Infern0451/t7bridge/enclosure/README.md

# T7 Bridge enclosure (3D printed)

Sealed two-part case for an ESP32-S3 DevKitC-style board **without pin
headers** (measured board: 57 × 28.1 mm plus a 6 × 18 mm antenna tab, 4.8 mm
tall). Outside size: **97.2 × 36.3 × 14.0 mm**, all outside edges rounded
(1.5 mm fillet).

## Pick your version

The cable goes into the board's **USB** port. On many of these boards only the
USB port has the resistors that make USB-C chargers, power banks, laptops and
the bike's own USB-C port switch their 5 V on; the COM port only powers up from
USB-A cables and "dumb" 12 V converters. Pick the version by your cable's
thickness, not counting the strain relief:

| Version | Cable hole | For cables |
|---|---|---|
| `type1` | 5.0 mm | up to ~4.6 mm (most Anker, Belkin, Amazon Basics braided) |
| `type2` | 6.5 mm | up to ~6 mm (heavy braided) |

Each version is one **3MF** file (`print/t7bridge_case_type1.3mf` or
`..._type2.3mf`) with the base, lid and gasket laid out on one plate, already
in print orientation: open it in Orca / Bambu Studio / PrusaSlicer. The parts
are separate objects, so you can give the gasket TPU or delete it if you use
RTV instead.

The board goes in **components up** (silver metal shield and buttons visible,
pin labels facing the floor). Its edges rest on the floor ribs, a stop at the
port end keeps it from sliding, and two pads under the lid (over the metal
shield and over the USB-C sockets) stop it lifting over that stop. The pads
clear the board by 0.5 mm, so nothing is pressed on.

On the project's N16R8 board the two USB-C ports are 11.8 mm apart and
symmetric about the centreline; components up, USB is on the left. For a
different board edit `PORT_OFFSETS`; for a COM-port case run
`python3 make_case.py --port com`.

| Part | Print in | Orientation (as exported) |
|---|---|---|
| base | PETG | open side up |
| lid | PETG | top face on the bed, lip up |
| gasket | TPU 95A (optional) | flat |

**Print settings (PETG):** 0.2 mm layers, **4 perimeters** (helps keep water
out), 3 top/bottom layers or more, 25-40 % infill, no supports. The zip-tie
channels on the bottom faces are short bridges that print fine.

## What you need

- A **short USB-C cable with a straight plug** on the board end. The case
  holds the plug inside: up to about 27 mm from the metal tip to the end of
  the strain relief, 13 mm wide and 7.5 mm thick. The bike end can be
  right-angled.
- Either the printed TPU gasket or a tube of **neutral-cure RTV silicone**.
- **Two zip ties** up to 5 mm wide.
- Optional: a small piece of foam tape on top of the board to stop rattles.
- **3M VHB** tape for mounting.

## Assembly

1. **Dry-fit first.** Put the board in (components up, antenna end against
   the far wall, USB end towards the notch), close the lid, check it seats.
2. Plug the cable into the board's **USB** port and lay the cable in the notch.
3. Fit the gasket in the groove, **or** run a thin bead of RTV in the groove.
   Add a dab of RTV around the cable where it passes through the notch.
4. Press the lid on and fit two zip ties in the channels, snug, not crushing.
5. Mount with VHB on the flat bottom between the channels.

Keep metal (brackets, foil tape) away from the antenna end, opposite the USB
plug.

## Changing the size

All dimensions are at the top of `make_case.py`. Edit them and run:

```sh
python3 make_case.py                      # type1 and type2 (USB port)
python3 make_case.py --port com --cable 1 # a COM-port version
```

(Needs Python 3 and numpy.) It regenerates the 3MF files and checks every
part is watertight. Add `--stl` for separate STL files too (about 20 MB
each, too big for GitHub's web upload, so they aren't in the repo).

## License

CC BY-SA 4.0 (see `LICENSE` in this folder). Share and remix freely, with credit, under the same license.
