Infern0451/t7bridge/enclosure/print/t7bridge_case_type1.3mf

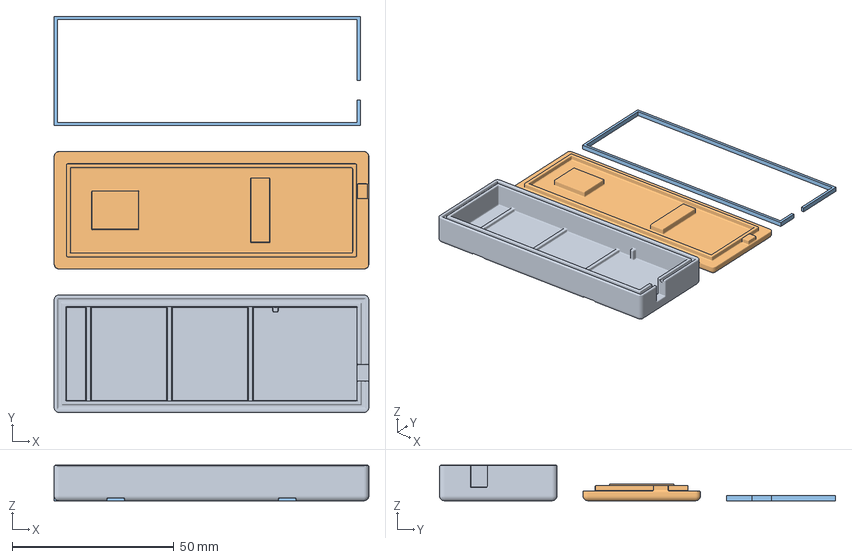
[picture p1: CAD file, 2026-11-12]
enclosure/print/t7bridge_case_type1.3mf
97.2 x 122.3 x 11.0 mm
base
lid
gasket (TPU, optional)
