Infern0451/t7bridge/(list of files, cad)

Other CAD files:
enclosure/print/t7bridge_case_type2.3mf
