Infern0451/t7bridge/main/learn_mode.c

/*
 * Learn mode. See learn_mode.h.
 */
#include "learn_mode.h"

#include <stdarg.h>
#include <stdio.h>
#include <string.h>

#include "driver/gpio.h"
#include "esp_log.h"
#include "esp_system.h"
#include "freertos/FreeRTOS.h"
#include "freertos/task.h"
#include "host/ble_hs.h"
#include "host/ble_store.h"
#include "nvs.h"
#include "services/gap/ble_svc_gap.h"

#include "creds.h"
#include "iphone_link.h"
#include "ota_update.h"
#include "yamaha_proto.h"

static const char *TAG = "learn";

#define BOOT_GPIO          GPIO_NUM_0
#define RESET_HOLD_MS      5000
#define FINISH_DELAY_MS    8000     /* keep the app link a while after the ACK */

/* Nordic UART Service, same UUIDs as the CCU. */
static const ble_uuid128_t NUS_SVC = BLE_UUID128_INIT(
    0x9E, 0xCA, 0xDC, 0x24, 0x0E, 0xE5, 0xA9, 0xE0, 0x93, 0xF3, 0xA3, 0xB5, 0x01, 0x00, 0x40, 0x6E);
static const ble_uuid128_t NUS_RX = BLE_UUID128_INIT(
    0x9E, 0xCA, 0xDC, 0x24, 0x0E, 0xE5, 0xA9, 0xE0, 0x93, 0xF3, 0xA3, 0xB5, 0x02, 0x00, 0x40, 0x6E);
static const ble_uuid128_t NUS_TX = BLE_UUID128_INIT(
    0x9E, 0xCA, 0xDC, 0x24, 0x0E, 0xE5, 0xA9, 0xE0, 0x93, 0xF3, 0xA3, 0xB5, 0x03, 0x00, 0x40, 0x6E);

static uint16_t s_tx_val;
static volatile bool s_synced;
static volatile bool s_running;
static volatile uint16_t s_conn = BLE_HS_CONN_HANDLE_NONE;
static volatile int64_t s_finish_at;      /* 0 = not finishing */
static uint8_t s_own_addr_type;
static char s_name[32];

static uint8_t s_buf[YAM_LEN_AUTH];
static size_t s_buf_len;
static int s_other_writes;

static int64_t now_ms(void)
{
    return (int64_t)(xTaskGetTickCount() * portTICK_PERIOD_MS);
}

/* Recent learn-mode events, shown on the setup page (no computer needed). */
#define EV_LINES 24
#define EV_LEN   96
static char s_ev[EV_LINES][EV_LEN];
static int s_ev_next, s_ev_count;
static portMUX_TYPE s_ev_mux = portMUX_INITIALIZER_UNLOCKED;

static void ev(const char *fmt, ...)
{
    char line[EV_LEN];
    int64_t t = now_ms();
    int n = snprintf(line, sizeof line, "%3d:%02d  ", (int)(t / 60000), (int)(t / 1000 % 60));
    va_list ap;
    va_start(ap, fmt);
    vsnprintf(line + n, sizeof line - n, fmt, ap);
    va_end(ap);
    ESP_LOGI(TAG, "%s", line + n);
    portENTER_CRITICAL(&s_ev_mux);
    memcpy(s_ev[s_ev_next], line, EV_LEN);
    s_ev_next = (s_ev_next + 1) % EV_LINES;
    if (s_ev_count < EV_LINES) {
        s_ev_count++;
    }
    portEXIT_CRITICAL(&s_ev_mux);
}

size_t learn_mode_events(char *buf, size_t cap)
{
    size_t used = 0;
    buf[0] = 0;
    portENTER_CRITICAL(&s_ev_mux);
    int first = (s_ev_next - s_ev_count + EV_LINES) % EV_LINES;
    for (int i = 0; i < s_ev_count && used + EV_LEN + 2 < cap; i++) {
        used += snprintf(buf + used, cap - used, "%s\n", s_ev[(first + i) % EV_LINES]);
    }
    portEXIT_CRITICAL(&s_ev_mux);
    return used;
}

/* ---------------------------------------------------------------------- */
/* The real CCU's advertising, recorded so learn mode can replay it exactly. */
/* Newer CCUs advertise more than their name (e.g. an Apple notification    */
/* service solicitation), and some Y-Connect versions check for it.         */
/* ---------------------------------------------------------------------- */

#define ADV_MAX 31
static uint8_t s_cap_adv[ADV_MAX], s_cap_rsp[ADV_MAX];
static uint8_t s_cap_adv_len, s_cap_rsp_len;
static bool s_cap_loaded, s_cap_complete, s_cap_dirty;
static int64_t s_cap_adv_at;

static void hex(char *out, size_t cap, const uint8_t *d, size_t n)
{
    size_t o = 0;
    for (size_t i = 0; i < n && o + 3 <= cap; i++) {
        o += snprintf(out + o, cap - o, "%02X", d[i]);
    }
    if (o == 0 && cap > 0) {
        out[0] = 0;
    }
}

static void cap_load(void)
{
    if (s_cap_loaded) {
        return;
    }
    s_cap_loaded = true;
    nvs_handle_t h;
    if (nvs_open("t7creds", NVS_READONLY, &h) != ESP_OK) {
        return;
    }
    size_t a = ADV_MAX, r = ADV_MAX;
    if (nvs_get_blob(h, "ccu_adv", s_cap_adv, &a) == ESP_OK && a > 0) {
        s_cap_adv_len = (uint8_t)a;
        if (nvs_get_blob(h, "ccu_rsp", s_cap_rsp, &r) == ESP_OK) {
            s_cap_rsp_len = (uint8_t)r;
        }
        s_cap_complete = true;
    }
    nvs_close(h);
}

static void cap_save(void)
{
    nvs_handle_t h;
    if (nvs_open("t7creds", NVS_READWRITE, &h) != ESP_OK) {
        return;
    }
    nvs_set_blob(h, "ccu_adv", s_cap_adv, s_cap_adv_len);
    if (s_cap_rsp_len) {
        nvs_set_blob(h, "ccu_rsp", s_cap_rsp, s_cap_rsp_len);
    } else {
        nvs_erase_key(h, "ccu_rsp");
    }
    nvs_commit(h);
    nvs_close(h);
}

static void cap_finish(void)
{
    char hx[2 * ADV_MAX + 1];
    s_cap_complete = true;
    s_cap_dirty = true;
    cap_save();
    hex(hx, sizeof hx, s_cap_adv, s_cap_adv_len);
    ev("recorded the bike's advertising: %s", hx);
    if (s_cap_rsp_len) {
        hex(hx, sizeof hx, s_cap_rsp, s_cap_rsp_len);
        ev("recorded the bike's scan response: %s", hx);
    } else {
        ev("the bike sent no scan response");
    }
}

void learn_mode_capture(const uint8_t *data, uint8_t len, bool scan_rsp)
{
    cap_load();
    if (len > ADV_MAX) {
        len = ADV_MAX;
    }
    if (!scan_rsp) {
        if (s_cap_complete && len == s_cap_adv_len && memcmp(data, s_cap_adv, len) == 0) {
            return;                       /* nothing new */
        }
        memcpy(s_cap_adv, data, len);
        s_cap_adv_len = len;
        s_cap_rsp_len = 0;
        s_cap_complete = false;
        s_cap_adv_at = now_ms();          /* wait briefly for a scan response */
    } else if (s_cap_adv_len && !s_cap_complete) {
        memcpy(s_cap_rsp, data, len);
        s_cap_rsp_len = len;
        cap_finish();
    }
}

bool learn_mode_capture_complete(void)
{
    cap_load();
    if (!s_cap_complete && s_cap_adv_len && now_ms() - s_cap_adv_at > 3000) {
        cap_finish();                     /* no scan response from this CCU */
    }
    return s_cap_complete;
}

/* True if the recording is of the CCU we're posing as. */
static bool cap_usable(void)
{
    cap_load();
    if (!s_cap_complete || !s_cap_adv_len) {
        return false;
    }
    const char *id = creds_ccu_id();
    size_t n = strlen(id);
    for (size_t i = 0; i + n <= s_cap_adv_len; i++) {
        if (memcmp(s_cap_adv + i, id, n) == 0) {
            return true;
        }
    }
    for (size_t i = 0; i + n <= s_cap_rsp_len; i++) {
        if (memcmp(s_cap_rsp + i, id, n) == 0) {
            return true;
        }
    }
    return false;
}

/* Option: ask the phone to pair over Bluetooth when the app connects, like
 * the real CCU does. Off by default (Y-Connect worked without it in tests). */
static int s_pair_request = -1;

bool learn_mode_pair_request(void)
{
    if (s_pair_request < 0) {
        uint8_t v = 0;
        nvs_handle_t h;
        if (nvs_open("t7creds", NVS_READONLY, &h) == ESP_OK) {
            nvs_get_u8(h, "lm_pair", &v);
            nvs_close(h);
        }
        s_pair_request = v ? 1 : 0;
    }
    return s_pair_request == 1;
}

void learn_mode_set_pair_request(bool on)
{
    nvs_handle_t h;
    if (nvs_open("t7creds", NVS_READWRITE, &h) == ESP_OK) {
        nvs_set_u8(h, "lm_pair", on ? 1 : 0);
        nvs_commit(h);
        nvs_close(h);
    }
    s_pair_request = on ? 1 : 0;
    ev("option: ask the phone to pair = %s", on ? "ON" : "off");
}

bool learn_mode_active(void)
{
    return s_running;
}

/* ---------------------------------------------------------------------- */
/* GATT server: what the app sees as the CCU's UART                         */
/* ---------------------------------------------------------------------- */

static void send_ack(uint16_t conn)
{
    struct os_mbuf *om = ble_hs_mbuf_from_flat(YAM_ACK, YAM_LEN_ACK);
    if (om == NULL || ble_gatts_notify_custom(conn, s_tx_val, om) != 0) {
        ev("could not send the ACK to the app (code is saved anyway)");
    } else {
        ev("sent the CCU's ACK to the app");
    }
}

static void handle_auth_frame(uint16_t conn, const uint8_t *f)
{
    yam_auth_info_t info;
    if (!yam_parse_auth(f, YAM_LEN_AUTH, &info)) {
        ev("app sent a session-init with a bad checksum; ignored");
        return;
    }
    if (info.mode == YAM_AUTH_RECONNECT) {
        ev("app sent the RECONNECT form (it thinks it's already paired); "
           "waiting for the pairing form");
        return;   /* no ACK: the app then sends the initial-pair form */
    }
    ev("app sent the PAIRING form: CCU ID %s, code ******", info.ccu_id);
    if (strcmp(info.ccu_id, creds_ccu_id()) != 0) {
        ESP_LOGW(TAG, "the app's CCU ID differs from ours (%s); using the app's", creds_ccu_id());
        if (!creds_set_ccu_id(info.ccu_id)) {
            ESP_LOGE(TAG, "app's CCU ID is not valid; not saved");
            return;
        }
    }
    /* Set the finish time first: the bridge task ends learn mode as soon as
     * it sees a stored code. */
    s_finish_at = now_ms() + FINISH_DELAY_MS;
    if (!creds_set_pairing_code(info.pairing_code)) {
        s_finish_at = 0;
        ESP_LOGE(TAG, "app's pairing code is not valid; not saved");
        return;
    }
    ev("*** pairing code learned and saved ***");
    send_ack(conn);
}

static int rx_access(uint16_t conn, uint16_t attr, struct ble_gatt_access_ctxt *ctxt, void *arg)
{
    if (ctxt->op != BLE_GATT_ACCESS_OP_WRITE_CHR) {
        return BLE_ATT_ERR_UNLIKELY;
    }
    uint8_t data[256];
    uint16_t len = OS_MBUF_PKTLEN(ctxt->om);
    if (len > sizeof data) {
        len = sizeof data;
    }
    if (ble_hs_mbuf_to_flat(ctxt->om, data, len, &len) != 0) {
        return BLE_ATT_ERR_UNLIKELY;
    }
    if (!s_running) {
        return 0;   /* not in learn mode: ignore quietly */
    }
    if (s_buf_len == 0 && (len == 0 || data[0] != 0xAA)) {
        if (s_other_writes++ < 20) {
            ev("app wrote %u bytes starting %02X%02X (not session-init)", len,
               len > 0 ? data[0] : 0, len > 1 ? data[1] : 0);
            ESP_LOG_BUFFER_HEX(TAG, data, len);
        }
        return 0;
    }
    /* Session-init carries the pairing code and the app's token: log only
     * the length, so logs are safe to share. */
    ESP_LOGI(TAG, "app wrote %u bytes of session-init", len);
    for (uint16_t i = 0; i < len; i++) {
        s_buf[s_buf_len++] = data[i];
        if (s_buf_len == YAM_LEN_AUTH) {
            handle_auth_frame(conn, s_buf);
            s_buf_len = 0;
        }
    }
    return 0;
}

static int tx_access(uint16_t conn, uint16_t attr, struct ble_gatt_access_ctxt *ctxt, void *arg)
{
    return BLE_ATT_ERR_READ_NOT_PERMITTED;
}

static const struct ble_gatt_svc_def s_svcs[] = {
    {
        .type = BLE_GATT_SVC_TYPE_PRIMARY,
        .uuid = &NUS_SVC.u,
        .characteristics = (struct ble_gatt_chr_def[]){
            {
                .uuid = &NUS_RX.u,
                .access_cb = rx_access,
                .flags = BLE_GATT_CHR_F_WRITE | BLE_GATT_CHR_F_WRITE_NO_RSP,
            },
            {
                .uuid = &NUS_TX.u,
                .access_cb = tx_access,
                .val_handle = &s_tx_val,
                .flags = BLE_GATT_CHR_F_NOTIFY,
            },
            {0},
        },
    },
    {0},
};

void learn_mode_register_gatt(void)
{
    int rc = ble_gatts_count_cfg(s_svcs);
    if (rc == 0) {
        rc = ble_gatts_add_svcs(s_svcs);
    }
    if (rc != 0) {
        ESP_LOGE(TAG, "UART service registration failed (rc %d)", rc);
    }
}

/* ---------------------------------------------------------------------- */
/* Advertising as the CCU                                                    */
/* ---------------------------------------------------------------------- */

static int gap_event(struct ble_gap_event *event, void *arg);

static void start_advertising(void)
{
    if (!s_running || s_conn != BLE_HS_CONN_HANDLE_NONE || ble_gap_adv_active()) {
        return;
    }
    int rc;
    bool replay = cap_usable();
    if (replay) {
        /* Exactly what the real CCU advertises. */
        rc = ble_gap_adv_set_data(s_cap_adv, s_cap_adv_len);
        if (rc == 0) {
            rc = ble_gap_adv_rsp_set_data(s_cap_rsp, s_cap_rsp_len);
        }
    } else {
        /* Not recorded yet: name, plus the Apple notification service
         * solicitation newer CCUs put in their scan response. */
        static const uint8_t rsp[] = {
            0x11, 0x15,   /* 128-bit service solicitation: ANCS */
            0xD0, 0x00, 0x2D, 0x12, 0x1E, 0x4B, 0x0F, 0xA4,
            0x99, 0x4E, 0xCE, 0xB5, 0x31, 0xF4, 0x05, 0x79,
        };
        struct ble_hs_adv_fields f = {0};
        f.flags = BLE_HS_ADV_F_DISC_GEN | BLE_HS_ADV_F_BREDR_UNSUP;
        f.name = (const uint8_t *)s_name;
        f.name_len = strlen(s_name);
        f.name_is_complete = 1;
        rc = ble_gap_adv_set_fields(&f);
        if (rc == 0) {
            rc = ble_gap_adv_rsp_set_data(rsp, sizeof rsp);
        }
    }
    if (rc != 0) {
        ESP_LOGE(TAG, "advertising data rejected (rc %d)", rc);
        return;
    }
    struct ble_gap_adv_params p = {0};
    p.conn_mode = BLE_GAP_CONN_MODE_UND;
    p.disc_mode = BLE_GAP_DISC_MODE_GEN;
    p.itvl_min = 160;
    p.itvl_max = 240;
    rc = ble_gap_adv_start(s_own_addr_type, NULL, BLE_HS_FOREVER, &p, gap_event, NULL);
    if (rc != 0) {
        ESP_LOGE(TAG, "advertising start failed (rc %d)", rc);
        return;
    }
    ev("advertising as \"%s\" (%s): pair the bike in Y-Connect now", s_name,
       replay ? "exact copy of the bike" : "not recorded yet: ignition on near the bridge once");
}

static int gap_event(struct ble_gap_event *event, void *arg)
{
    struct ble_gap_conn_desc desc;
    switch (event->type) {
    case BLE_GAP_EVENT_CONNECT:
        if (event->connect.status != 0) {
            start_advertising();
            return 0;
        }
        s_conn = event->connect.conn_handle;
        s_buf_len = 0;
        s_other_writes = 0;
        if (ble_gap_conn_find(s_conn, &desc) == 0) {
            ev("app connected (from %02X:%02X:%02X:%02X:%02X:%02X)",
                     desc.peer_ota_addr.val[5], desc.peer_ota_addr.val[4], desc.peer_ota_addr.val[3],
                     desc.peer_ota_addr.val[2], desc.peer_ota_addr.val[1], desc.peer_ota_addr.val[0]);
        }
        if (learn_mode_pair_request()) {
            ev("asking the phone to pair (option on)");
            ble_gap_security_initiate(s_conn);
        }
        /* By default no Bluetooth pairing: Y-Connect sent the code without it
         * in tests. Some app versions / first-time registrations may want it,
         * hence the option on the setup page. */
        return 0;

    case BLE_GAP_EVENT_ENC_CHANGE:
        ev("app link encryption: %s (0x%x)",
                 event->enc_change.status == 0 ? "on" : "failed", event->enc_change.status);
        return 0;

    case BLE_GAP_EVENT_REPEAT_PAIRING:
        if (ble_gap_conn_find(event->repeat_pairing.conn_handle, &desc) == 0) {
            ble_store_util_delete_peer(&desc.peer_id_addr);
        }
        return BLE_GAP_REPEAT_PAIRING_RETRY;

    case BLE_GAP_EVENT_SUBSCRIBE:
        ev("app %s notifications on handle %u",
                 event->subscribe.cur_notify ? "enabled" : "disabled", event->subscribe.attr_handle);
        return 0;

    case BLE_GAP_EVENT_MTU:
        ev("app MTU %u", event->mtu.value);
        return 0;

    case BLE_GAP_EVENT_DISCONNECT:
        ev("app disconnected (reason 0x%x)", event->disconnect.reason);
        s_conn = BLE_HS_CONN_HANDLE_NONE;
        start_advertising();
        return 0;

    case BLE_GAP_EVENT_ADV_COMPLETE:
        start_advertising();
        return 0;

    default:
        return 0;
    }
}

/* ---------------------------------------------------------------------- */
/* Start / stop                                                              */
/* ---------------------------------------------------------------------- */

static void start(void)
{
    snprintf(s_name, sizeof s_name, "YCCU_%s", creds_ccu_id());
    s_running = true;
    s_finish_at = 0;
    iphone_link_suspend_advertising(true);
    ble_svc_gap_device_name_set(s_name);
    ESP_LOGW(TAG, "LEARN MODE. Turn the ignition OFF (or move away from the bike), then pair "
                  "the bike in the Yamaha Y-Connect app. It will connect to this bridge.");
    start_advertising();
}

static void stop(void)
{
    s_running = false;
    if (s_conn != BLE_HS_CONN_HANDLE_NONE) {
        ble_gap_terminate(s_conn, BLE_ERR_REM_USER_CONN_TERM);
    }
    if (ble_gap_adv_active()) {
        ble_gap_adv_stop();
    }
    ble_svc_gap_device_name_set("t7bridge");
    iphone_link_suspend_advertising(false);
    ESP_LOGI(TAG, "learn mode finished; the bridge will now pair with the real CCU. "
                  "Turn the ignition on. You can delete Y-Connect from the phone you used.");
}

void learn_mode_on_sync(void)
{
    /* Pose as the CCU under a separate random address. iOS remembers the
     * "CCU" by address and Y-Connect keeps reconnecting to it; with the real
     * address it would land on "t7bridge" afterwards and pop up pairing
     * requests. This address simply disappears when learn mode ends. */
    ble_addr_t rnd;
    if (ble_hs_id_gen_rnd(0, &rnd) == 0 && ble_hs_id_set_rnd(rnd.val) == 0) {
        s_own_addr_type = BLE_OWN_ADDR_RANDOM;
    } else if (ble_hs_id_infer_auto(0, &s_own_addr_type) != 0) {
        ESP_LOGE(TAG, "no usable BLE address");
        return;
    }
    s_synced = true;
}

void learn_mode_factory_reset(void)
{
    ESP_LOGW(TAG, "factory reset: forgetting the bike and all Bluetooth pairings");
    creds_forget_bike();
    nvs_handle_t h;
    if (nvs_open("t7creds", NVS_READWRITE, &h) == ESP_OK) {
        nvs_erase_key(h, "ccu_adv");
        nvs_erase_key(h, "ccu_rsp");
        nvs_commit(h);
        nvs_close(h);
    }
    ble_store_clear();
    vTaskDelay(pdMS_TO_TICKS(500));
    esp_restart();
}

static void check_boot_button(int64_t now)
{
    static bool configured;
    static int64_t pressed_since;
    if (!configured) {
        gpio_config_t io = {
            .pin_bit_mask = 1ULL << BOOT_GPIO,
            .mode = GPIO_MODE_INPUT,
            .pull_up_en = GPIO_PULLUP_ENABLE,
        };
        gpio_config(&io);
        configured = true;
    }
    if (gpio_get_level(BOOT_GPIO) == 0) {
        if (pressed_since == 0) {
            pressed_since = now;
            ESP_LOGI(TAG, "BOOT pressed: keep holding 5 s to forget the bike");
        } else if (now - pressed_since >= RESET_HOLD_MS) {
            learn_mode_factory_reset();
        }
    } else {
        pressed_since = 0;
    }
}

void learn_mode_tick(int64_t now)
{
    (void)now;
    int64_t t = now_ms();
    check_boot_button(t);

    /* Keep the setup Wi-Fi on for as long as the bike's code is missing. */
    ota_update_hold(!creds_have_code());

    if (!s_synced) {
        return;
    }
    bool needed = creds_have_ccu_id() && !creds_have_code();
    if (s_running && s_cap_dirty && s_conn == BLE_HS_CONN_HANDLE_NONE) {
        /* Just recorded the bike's advertising: switch to the exact copy. */
        s_cap_dirty = false;
        if (ble_gap_adv_active()) {
            ble_gap_adv_stop();
        }
        start_advertising();
    }
    if (needed && !s_running) {
        start();
    } else if (s_running && creds_have_code() &&
               (s_finish_at == 0 || t >= s_finish_at)) {
        /* Code from the app (after a short pause for the ACK) or typed in. */
        stop();
    }
}
