Infern0451/t7bridge/(commit log)

2026-11-06 Update README.md
    Modified case dims to fit different cable types and provide appropriate offsets for port alignment.
2026-11-06 Delete enclosure/stl directory
    To be updated (see README)
    [t7bridge_base.stl, t7bridge_gasket.stl, t7bridge_lid.stl]
2026-11-08 1.2.3: learn-mode activity on the setup page; optional Bluetooth pairing request
    Learn mode now lists what the Yamaha app did (connect, MTU, subscribe, writes,
    disconnect reason) on the setup page, so pairing problems can be diagnosed
    without a computer. New option: ask the phone to pair over Bluetooth, for app
    versions or first-time registrations that expect it. Web installer updated.
    Claude-Session: https://claude.ai/code/session_013rC4QiQoxefreRuXa7WcKD
    [learn_mode.c, learn_mode.h, ota_update.c]
2026-11-10 1.2.4: learn mode replays the real CCU's advertising exactly
    A rider's MY26 T7: Y-Connect never even connected to the bridge (error 1007),
    while it pairs with the real CCU. His CCU advertises more than its name (an
    Apple notification service solicitation). The bridge now records the CCU's
    advertising data and scan response while scanning (ignition on, no pairing
    code yet) and replays them byte for byte in learn mode. Until recorded, it
    adds the ANCS solicitation to its scan response. Recording shows on the
    setup page and is cleared by Forget bike.
    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
    [ccu_link.c, learn_mode.c, learn_mode.h]
2026-11-12 1.2.5: battery level retried and refreshed; Apple-recommended advertising timing
    - The iPhone battery level was read once after connecting; if that read
    failed the TFT kept the placeholder for the whole ride (now that the
    bridge powers up with the ignition, that happened every ride). It's now
    retried every 10 s until a value arrives, then refreshed every 5 minutes.
    - Advertise at 20 ms for 30 s after start-up or a disconnect, then 152.5 ms,
    the intervals Apple recommends so iOS finds and reconnects to accessories
    quickly (a rider's iPhone didn't reconnect after a long time out of range).
    Claude-Session: https://claude.ai/code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
    [iphone_link.c]
2026-11-12 Case: standard files for the USB port (COM may not power from USB-C sources)
    On the project's clone N16R8 boards, the COM port has no CC resistors, so
    USB-C chargers, laptops, power banks and the bike's USB-C port don't switch
    on their 5 V for it; the USB port powers from anything. Standard case files
    now line up with the USB port; --port com still makes a COM version.
    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
    [t7bridge_case_type1.3mf, t7bridge_case_type2.3mf]
